jwagnerhki/e220_esp8266/(commit log)

2022-11-27 update comments incl board Arduino settings
2022-11-27 image of magnet mount with glued phototransistor
2022-11-27 board and cabling
2023-05-18 receive and store entire frame except for starter sequence, add some more docu, move a few strings into flash
